Axel06c/Gant-Musical-Arduino/README.md

# Musicano (Gant Musical Arduino)
Notre projet est de créer un __gant__ capable de __jouer des sons__ pour __créer de de la musique en touchant ses doigts et en déplaçant sa main dans l'espace__.

Celui-ci fonctionnera avec une carte __arduino nano__, qui permettra de collecter des données relatives au mouvement et au choix de son de l’utilisateur, afin de l’envoyer à l'__application android__ qui modifiera les sons c’est-à-dire la musique.

Plus précisément:
  - [ ] Les plaques d'aluminium ou __scotch en cuivre__ permettrons de faire contact entre les doigts quand on les presse contre le pouce.  
  - [ ] L'__accéléromètre__ pourra détecter le sens et la direction de déplacement de notre main. 
  - [ ] L'arduino devra récupérer toute ces données, pour ensuite les __analyser__ et finalement __envoyer__ une chaine de caractère codée __a l'application Android__.  
  - [ ] Cette application devra, en fonction des données récupérées, __lancer des sons, gérer leur volume et leur tempos__.  
  - [ ] Elle pourra également proposer des __banques de sons__ différentes, pour permettre à l'utilisateur de profiter d'un plus grand panel d'échantillons sonores (jazz,rock,pop...).
