Axel06c/Gant-Musical-Arduino/Rapports Séances/Axel Corneille/Semaine 8 (04.03.2020).md

Aujourd'hui nous avons du "fortifier" notre gant, nous avons scotché le maximum de fil au gant ainsi que la plaquette pour éviter au
maximum les faux contacts et  interférences.  
Nous avons également décidé de chercher comment l'améliorer pour qu'il puisse être plus "simple" d'utilisation.  
Et nous avons trouvé deux points négatif :  
- le gyroscope est trop "sensible"  
- l'interface de l'application est trop brouillon (pas d'apercu de son sélectionné, pas de visuel de tout les sons,...)  

J'ai donc commencé a améliorer l'interface, et je vais continuer jusqu'à l'oral final pour améliorer la comprehension.  
Ruben lui va essayer de diminuer la sensibilité du gyroscope.
