Axel06c/Gant-Musical-Arduino/Rapports Séances/Ruben Nakache/Séance 7.md

Un petit pas pour Axel et Ruben, un grand pas pour le Musicano, lors de cette séance nous avons réussi à rendre notre projet fonctionnel.

Tout d'abord  nous avons réduit la taille du montage arduino en prenant une plaque plus petite, cela nous as permis de scotché la plaque au gant ainsi notre projet est maintenant portable a l'aide du batterie portable à mettre dans une poche.

Nous avons également opté pour des plaques de cuivres cousues sur le gant au lieu du scotch de cuivre afin de facilité l'utilisation du Musicano.
Il nous a donc fallu reconnecter les fils dénudés, associés aux pins des doigts, aux plaques de cuivre (pour finaliser nos boutons).
Apres avoir vérifié l'allumage des composants alimentés par la batterie portable nous avons pu tester pour la 1ere fois le Musicano a son stade fonctionnel.

Pour cela nous avons connecté le module Bluetooth à l'application et avons fait les mouvements nécessaire a la modification du rythme et du volume avec le gant en ayant choisi un son de par la connexion  de la plaque de cuivre du pouce et de celle d'un doigt.
Et le résultat fut assez concluant, le rythme et le volume sont bien modifiés en fonction de nos mouvements et de façon plutôt correcte.
Finalement, nous avons pu faire tester le Musicano nos collègues de classe afin d'en avoir un retour .
(Merci à Maëlynn Muller qui s'est proposée en tant que beta testeuse)

(Même videos qu'Axel)
Test 1
Test 2
Test 3

Néanmoins il reste des modifications à faire quant à l'aspect esthétique du Musicano. 
Mais il est également nécessaire de modifier le code arduino responsable de l'acquisition et de la transformation en nombre des mouvements 
étant donner le peu de précision des mouvements.

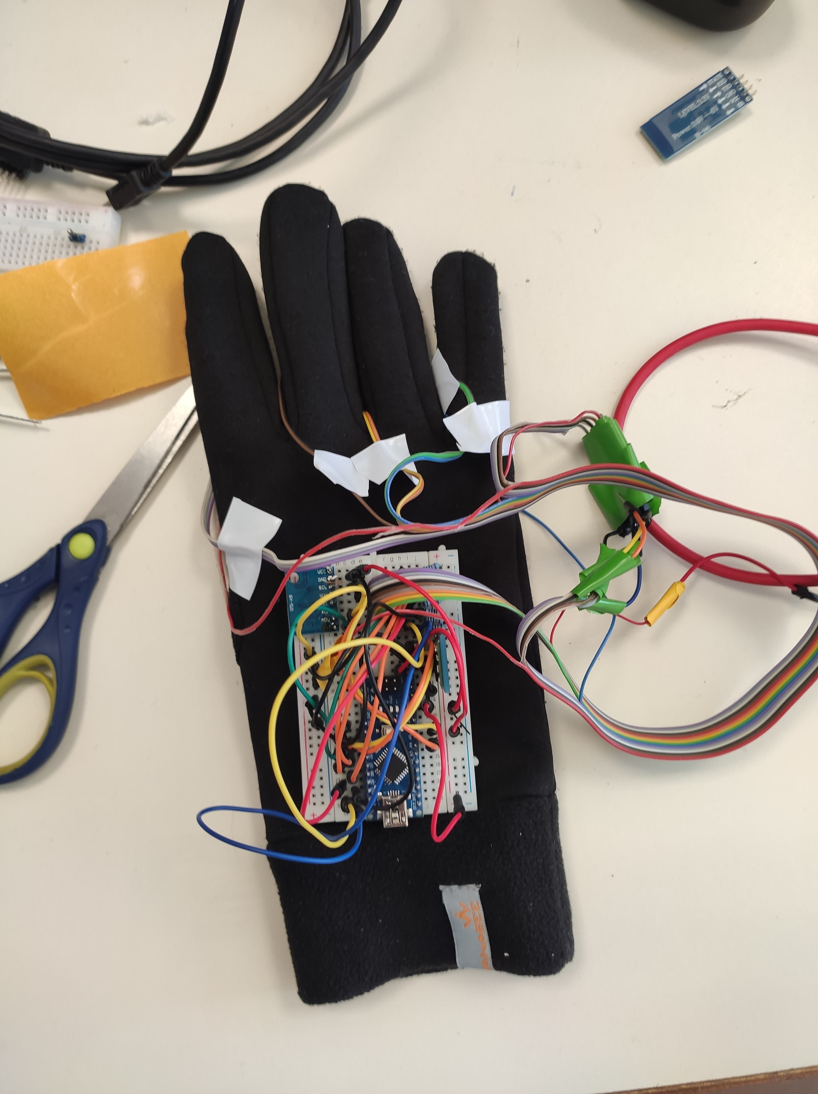
[picture p1: lib/Images/Musicano fonctionnel1.jpg]
Musicano fonctionnel 1

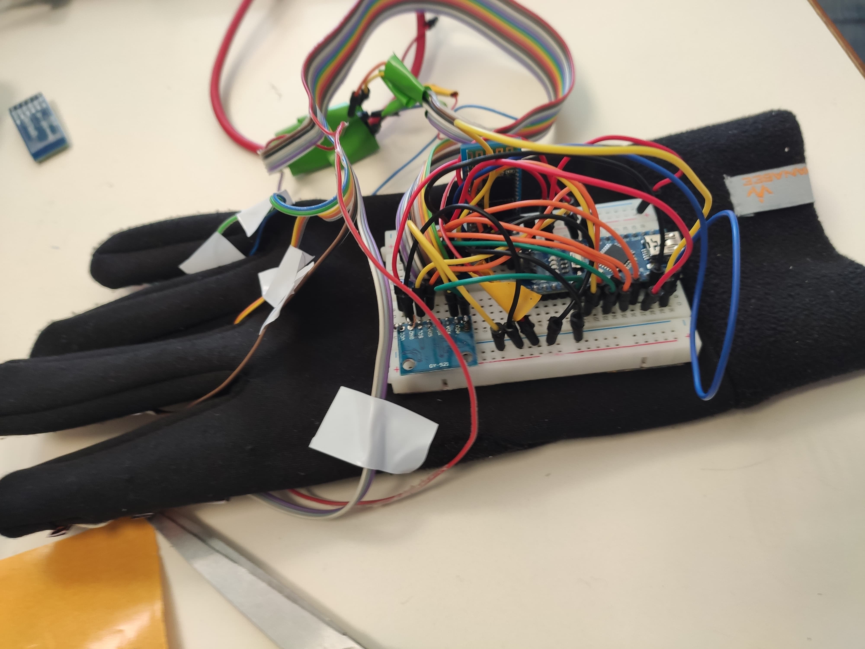
[picture p2: lib/Images/Musicano fonctionnel 2.jpg]
Musicano fonctionnel 2
