Axel06c/Gant-Musical-Arduino/Rapports Séances/Axel Corneille/Semaine 7 (19.01.2020).md

Cette semaine nous avons réduit la place que prenait notre montage en optimisant la place prise par tout les cable et composants.
J'ai également cousu les barres de cuivres au gant pour que tout soit correctement tenus.  
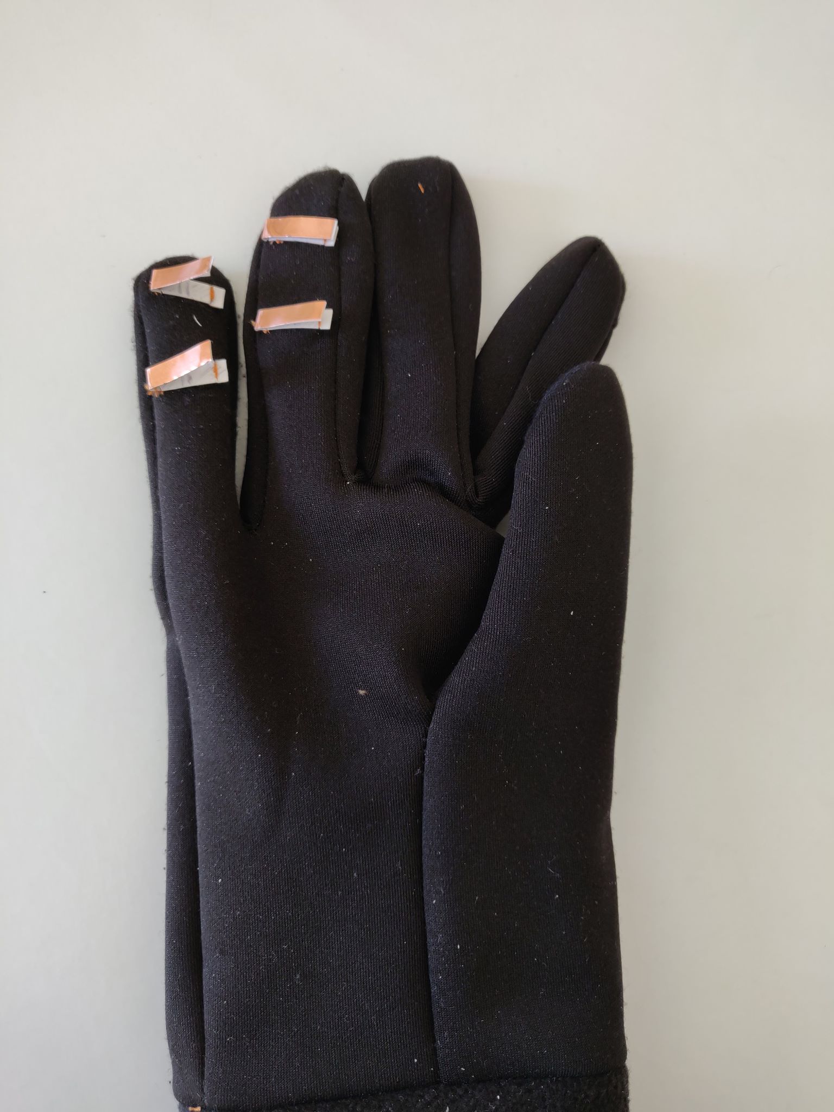
[picture p3: lib/Images/Couture cuivre gant.jpg]
Couture gant
  

Nous avons enfin fait les réglages finaux pour tester finalement le gant.
Et il fonctionne! tout marche comme l'on voulait, mise a part la praticité de fonctionnement qui reste a désirer et la sensibilité qui est trop élevée.
vidéo gant 1
vidéo gant 2
vidéo gant 3

La prochaine étape sera de baisser la sensibilité et essayer d'améliorer les petits problèmes d'executions.
