Axel06c/Gant-Musical-Arduino/Rapports Séances/Axel Corneille/Semaine 3 (06.01.2020).md

Pendant les vacances j'ai travaillé sur l'intégration du bluetooth a mon application.
je me suis renseigné sur internet, et je n'ai trouvé que des essais inachevés.
j'ai donc combiné toutes mes recherches et j'ai reussi a faire un codetrès pratique a l'utilisation dans le cadre de notre projet.
je m'explique : j'ai pu mettres les fonctions dédiées a la connection dans un coté à part dans le code et j'ai pu réserver une zone spéciale pour le traitement des données reçues.
Le code est donc bien comprehensible et plus pratique.
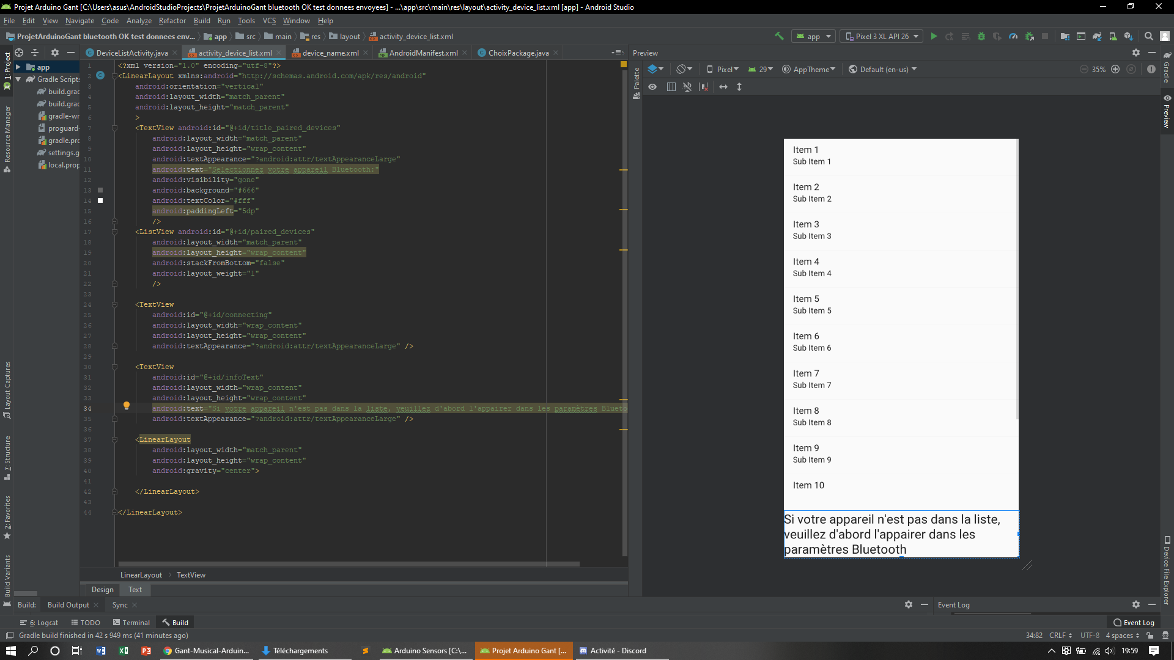
[picture p12: lib/Images/Selectionner Bluetooth.png]
Connection appareil bluetooth


Pendant la séance, avec Ruben nous avons mis en commun nos avancées pour voir comment être plus productif pour la suite.
On a également eu un problème au niveau de l'envoi des données bluetooth a partir de l'arduino (on envoyait un mauvais "format").
Nous avons également commencé a préparer le gant avec les petites feuilles de cuivre pour avoir un début de visuel pour la présentation orale des projet.
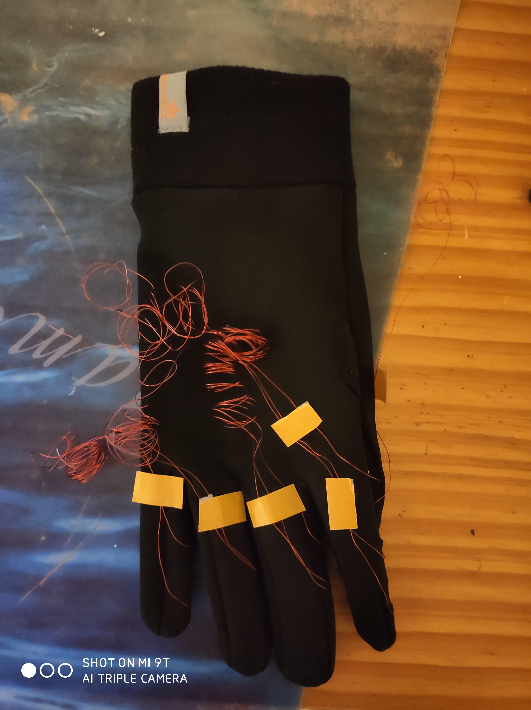
[picture p13: lib/Images/1er montage gant.jpg]
Gant en fin de séance
