Axel06c/Gant-Musical-Arduino/Rapports Séances/Axel Corneille/Semaine 2 (16.12.2019).md

Durant cette séance j'ai réussi a coder des boutons, des slidebars, ainsi que le système de son.
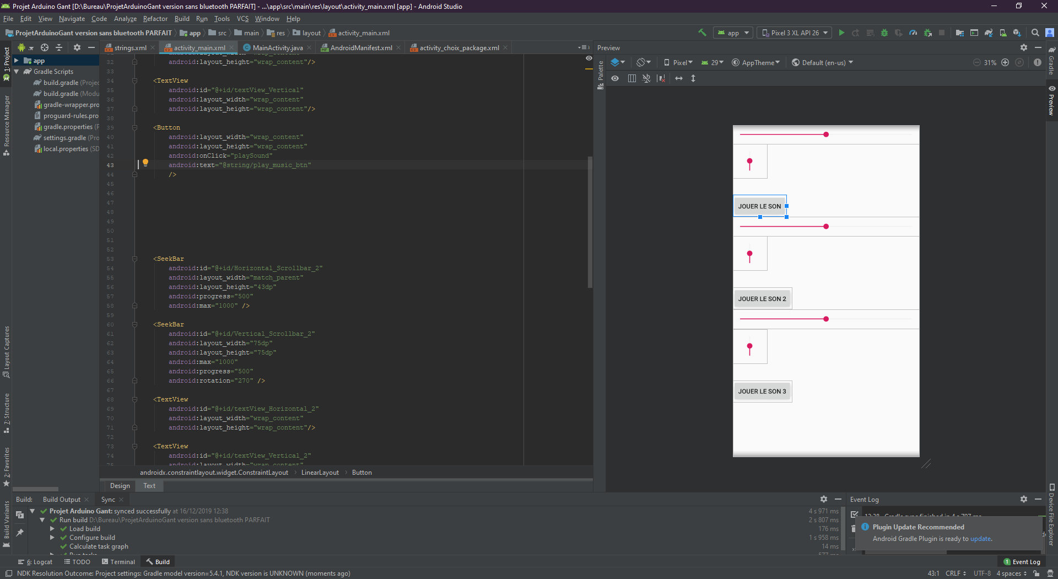
[picture p14: lib/Images/Seance 2.png]
Capture d'écran 2eme semaine

les boutons bouton lancent et mettent en pause la musique,
les slidebars verticaux slidebar verticale modifient le volume,
et les slidebars horizontaux slidebar horizontaux modifient le tempo.
J'ai récuperé sur internet quelques sons libres de droit, que j'ai inclus au projet.
J'ai également créé le lien entre l'interface permettant a l'utilisateur de choisir son pack de musique désiré et l'interface de musique.

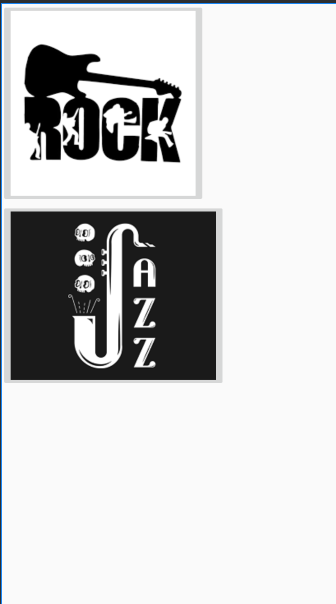
[picture p15: lib/Images/Choix de sons.png]
choix pack musique


Chaque pack de musique a ses propres sons.

Je met en release le premier APK de mon application, avec laquelle on peut déja gerer les sons.
