Axel06c/Gant-Musical-Arduino/README (cahier des charges).md

# Gant-Musical-Arduino
Notre projet est de créer un __gant__ capable de __jouer des sons__ pour __créer de de la musique__ en touchant ses doigts et en déplaçant sa main dans l'espace.

Celui-ci fonctionnera avec une carte arduino nano qui permettra de collecter les données relatives au mouvement et au choix de son de l’utilisateur afin de l’envoyer à l’application qui modifiera donc les sons c’est-à-dire la musique

Plus précisément:  
  - [ ] Les plaques d'alluminium ou scotch en cuivre permetterons de faire contact entre les doigts quand on les presse contre le pouce.  
  - [ ] L'acceleromètre pourra détecter le sens et la direction de déplacement de notre main. 
  - [ ] L'arduino devra récuperer toute ces données, pour ensuite les analyser et finalement envoyer une chaine de caractère codée a l'application Android.  
  - [ ] Cette application devra, en fonction des données récuperées, lancer des sons, gérer leur volume et leur tempos.  
  - [ ] Elle pourra également proposer des banques de sons différentes , pour permettre à l'utilisateur de profiter d'un plus grand panel d'echantillons sonores (jazz,rock,pop...).
