Axel06c/Gant-Musical-Arduino/Rapports Séances/Ruben Nakache/Séance 8 .md

Rapport de la séance 8 :
Lors de cette séance nous avons fait des ajustements et des optimisations du Musicano nous avons :
- fixé les fils sur le gant à l’aide de scotch noir pour que celui-ci soit peu visible et afin de restreindre les faux contacts
- réajusté les fils dans les plaques de cuivres, nous avons essayé de les souder aux plaques de cuivres mais cela n’est pas possible car les plaques ne sont pas assez grande et rigide
- fait des mises au point au niveau de l’interface de l’application, le son sélectionné lors du contact des plaques de cuivres sera indiqué par un changement de couleur de son image sur l’application
Cependant il reste des problèmes a corrigés, en effet la sensibilité du gyroscope est trop forte il faut donc changer le code pour corriger cela. Il faut aussi améliorer l’interface de l’application en ajoutant des informations.
Il faudrait aussi rendre le Musicano plus esthétique cependant ce problème nécessite de s’y pencher plus longtemps.
