Axel06c/Gant-Musical-Arduino/Rapports Séances/Ruben Nakache/Séance 4.md

Séance 4 :

Au cours de cette séance malgré un problème technique, j'ai effectué des tests avec le module Bluetooth afin d'envoyer des données à l'application
Android afin de finaliser la communication entre la carte arduino et l'application Android qui va les traiter d'une façon bien particulière.

En effet, après concertation avec mon partenaire Axel, nous avons prévu de les envoyer sous la forme suivante:

%choix du son ; volume ; rythme ; impulsion-

Avec:

-le choix du son qui correspond à un numéro établi comme plaque de cuivre sur le pouce connecté avec plaque de cuivre sur un des doigts

-l'impulsion qui est une donnée passant de 0 à 11 lors d'une impulsion ou d'un "mouvement brutal" et de 11 à 0 lors de la suivante et ainsi de suite.

Nous avons aussi repensé le montage au niveau du gant, nous nous sommes dit qu'il serait utile d'utiliser une plaque a essai afin d'alléger le montage.
Pour cela  nous pourrions brancher nos composants arduino à la plaque pour les souder en suite et nous pourrions y brancher les fils qui sont 
branchés aux plaque de cuivre donc aux doigts.
Ainsi il nous faut encore réfléchir au montage et à la façon dont allons devoir disposer nos composants.
