Axel06c/Gant-Musical-Arduino/Rapports Séances/Axel Corneille/Semaine 4 (13.01.2020).md

Durant cette séance, avec ruben nous nous sommes concertés de nouveau pour approfondir les données envoyées et reçues par bluetooth dans notre projet.

J'ai trouvé un moyen de couper les données reçues et les mettres dans un tableau de variable pour pouvoir avoir séparément les données pour : le doigt appuyé, les valeurs du déplacement pour le volume, les valeurs de déplacement pour le tempo, ainsi que si l'accelerateur est secoué.
