Axel06c/Gant-Musical-Arduino/Rapports Séances/Axel Corneille/Semaine 1 (09.12.2019).md

J'ai installé l'environnement Android studio, et me suis approprié l'environnement de travail ainsi que les fonctionnalités de base (afficher un texte, détecter quand un bouton est appuyé,...).
J'ai créé une petite application avec deux boutons qui seront sensés nous amener vers le pack de sons de notre choix.J'ai également fait en sorte qu'un texte s'affiche quand on appuie sur le bouton.
Je mettrais le code et l'application en release la semaine prochaine quand mon code sera plus complet.
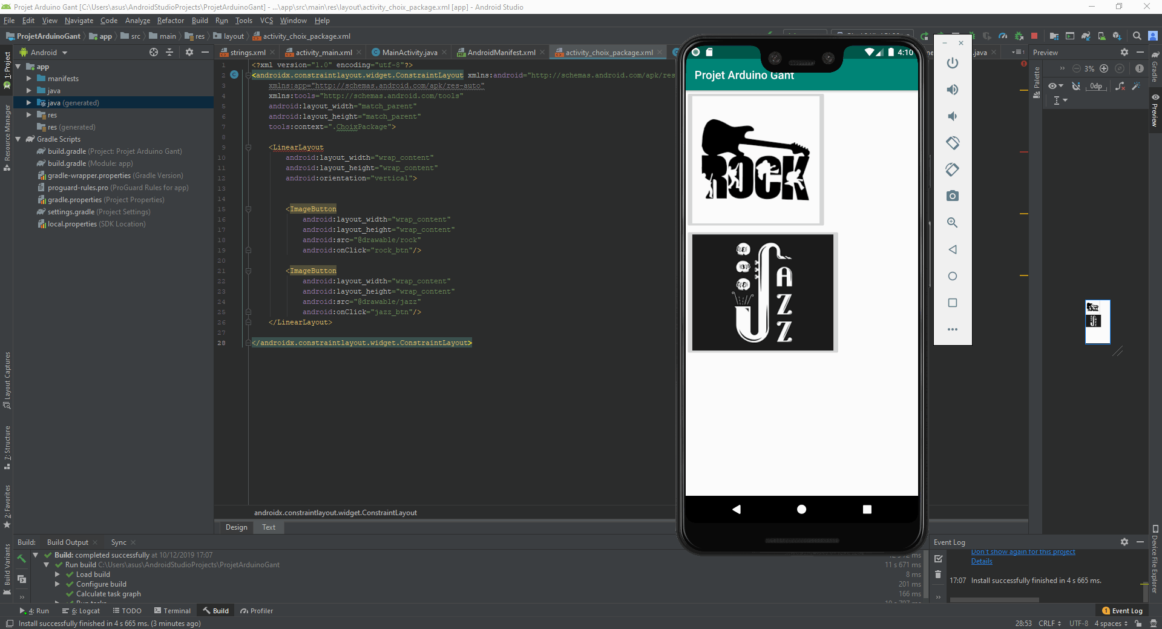
[picture p16: lib/Images/Seance 1.png]
Capture d'écran 1ère application
