Axel06c/Gant-Musical-Arduino/(commit log)

2019-11-29 Rename README.md to README (cahier des charges).md
2019-11-29 Update and rename README (cahier des charges).md to README.md
2019-11-29 Create Cahier des charges
2019-11-29 Update Cahier des charges
2020-02-07 Create Liste des fichiers arduino.md
2020-03-05 Create Rapport de la séance 8 .md
2020-03-05 Rename Rapport de la séance 8 .md to Séance 8 .md
